Edunts5962/console-nes-esp32/hardware/kicad/manette_nes/documents/manette_nes_schema.pdf

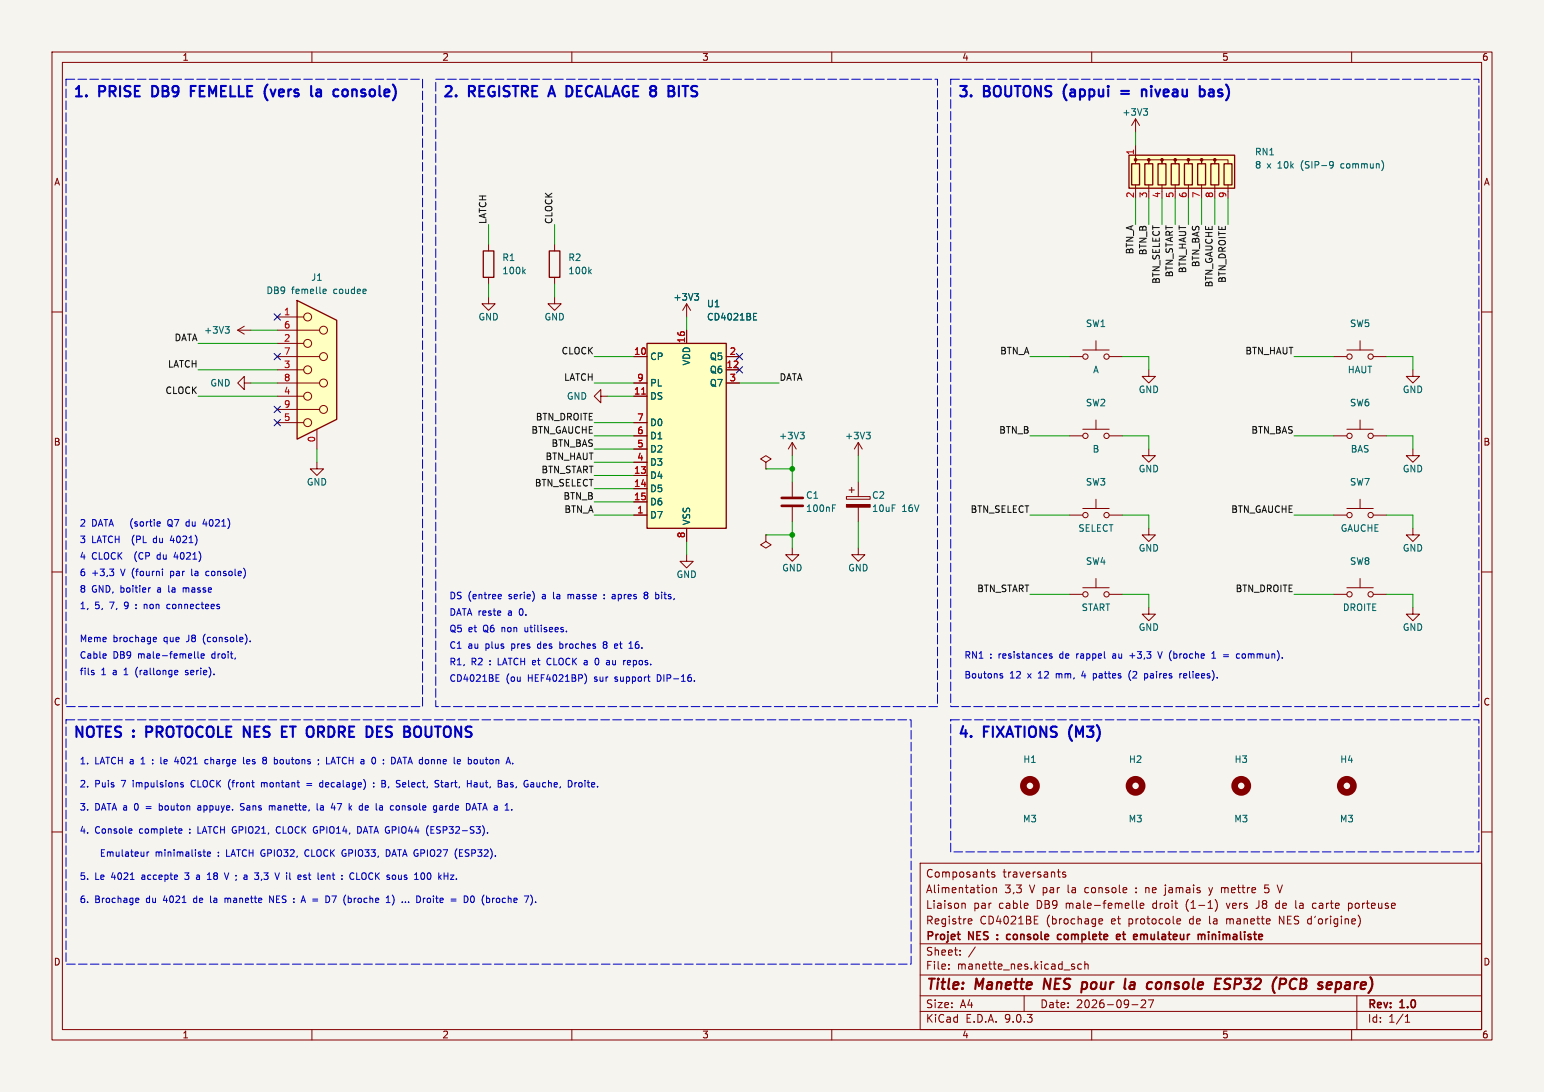
[picture p7: page 1]

Boutons 12 x 12 mm, 4 pattes (2 paires reliees).
