Edunts5962/console-nes-esp32/hardware/kicad/console_nes/documents/console_nes_placement.pdf

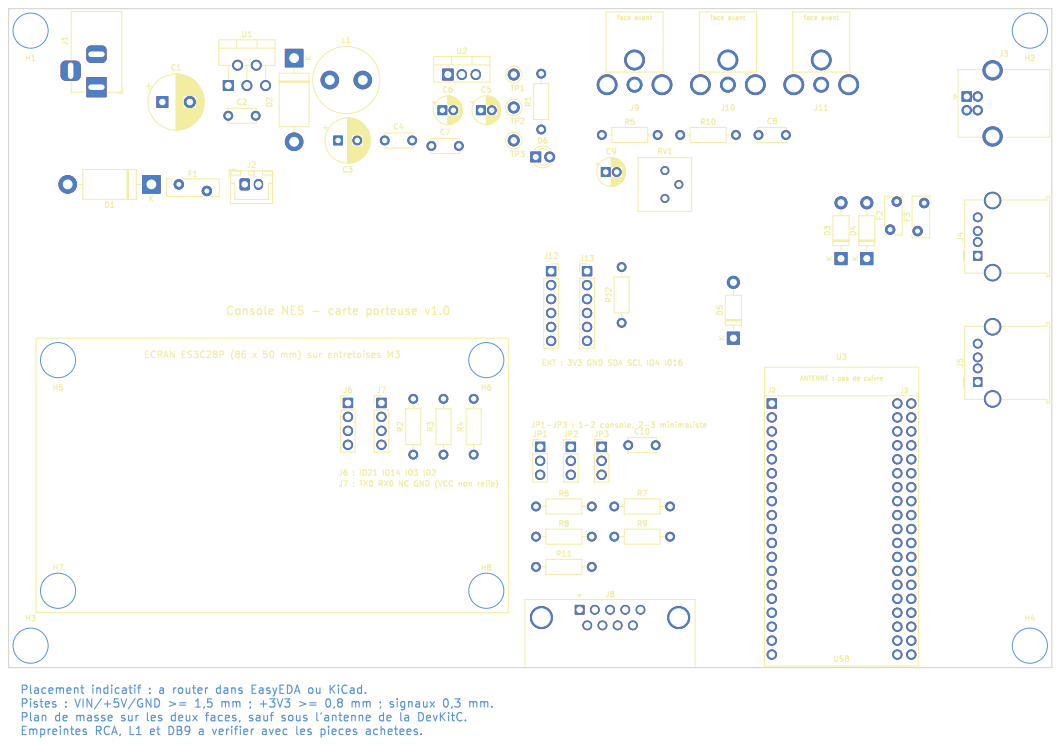
[picture p8: page 1]

ANTENNE : pas de cuivre USB
