Edunts5962/console-nes-esp32/hardware/kicad/console_nes/documents/console_nes_schema.pdf

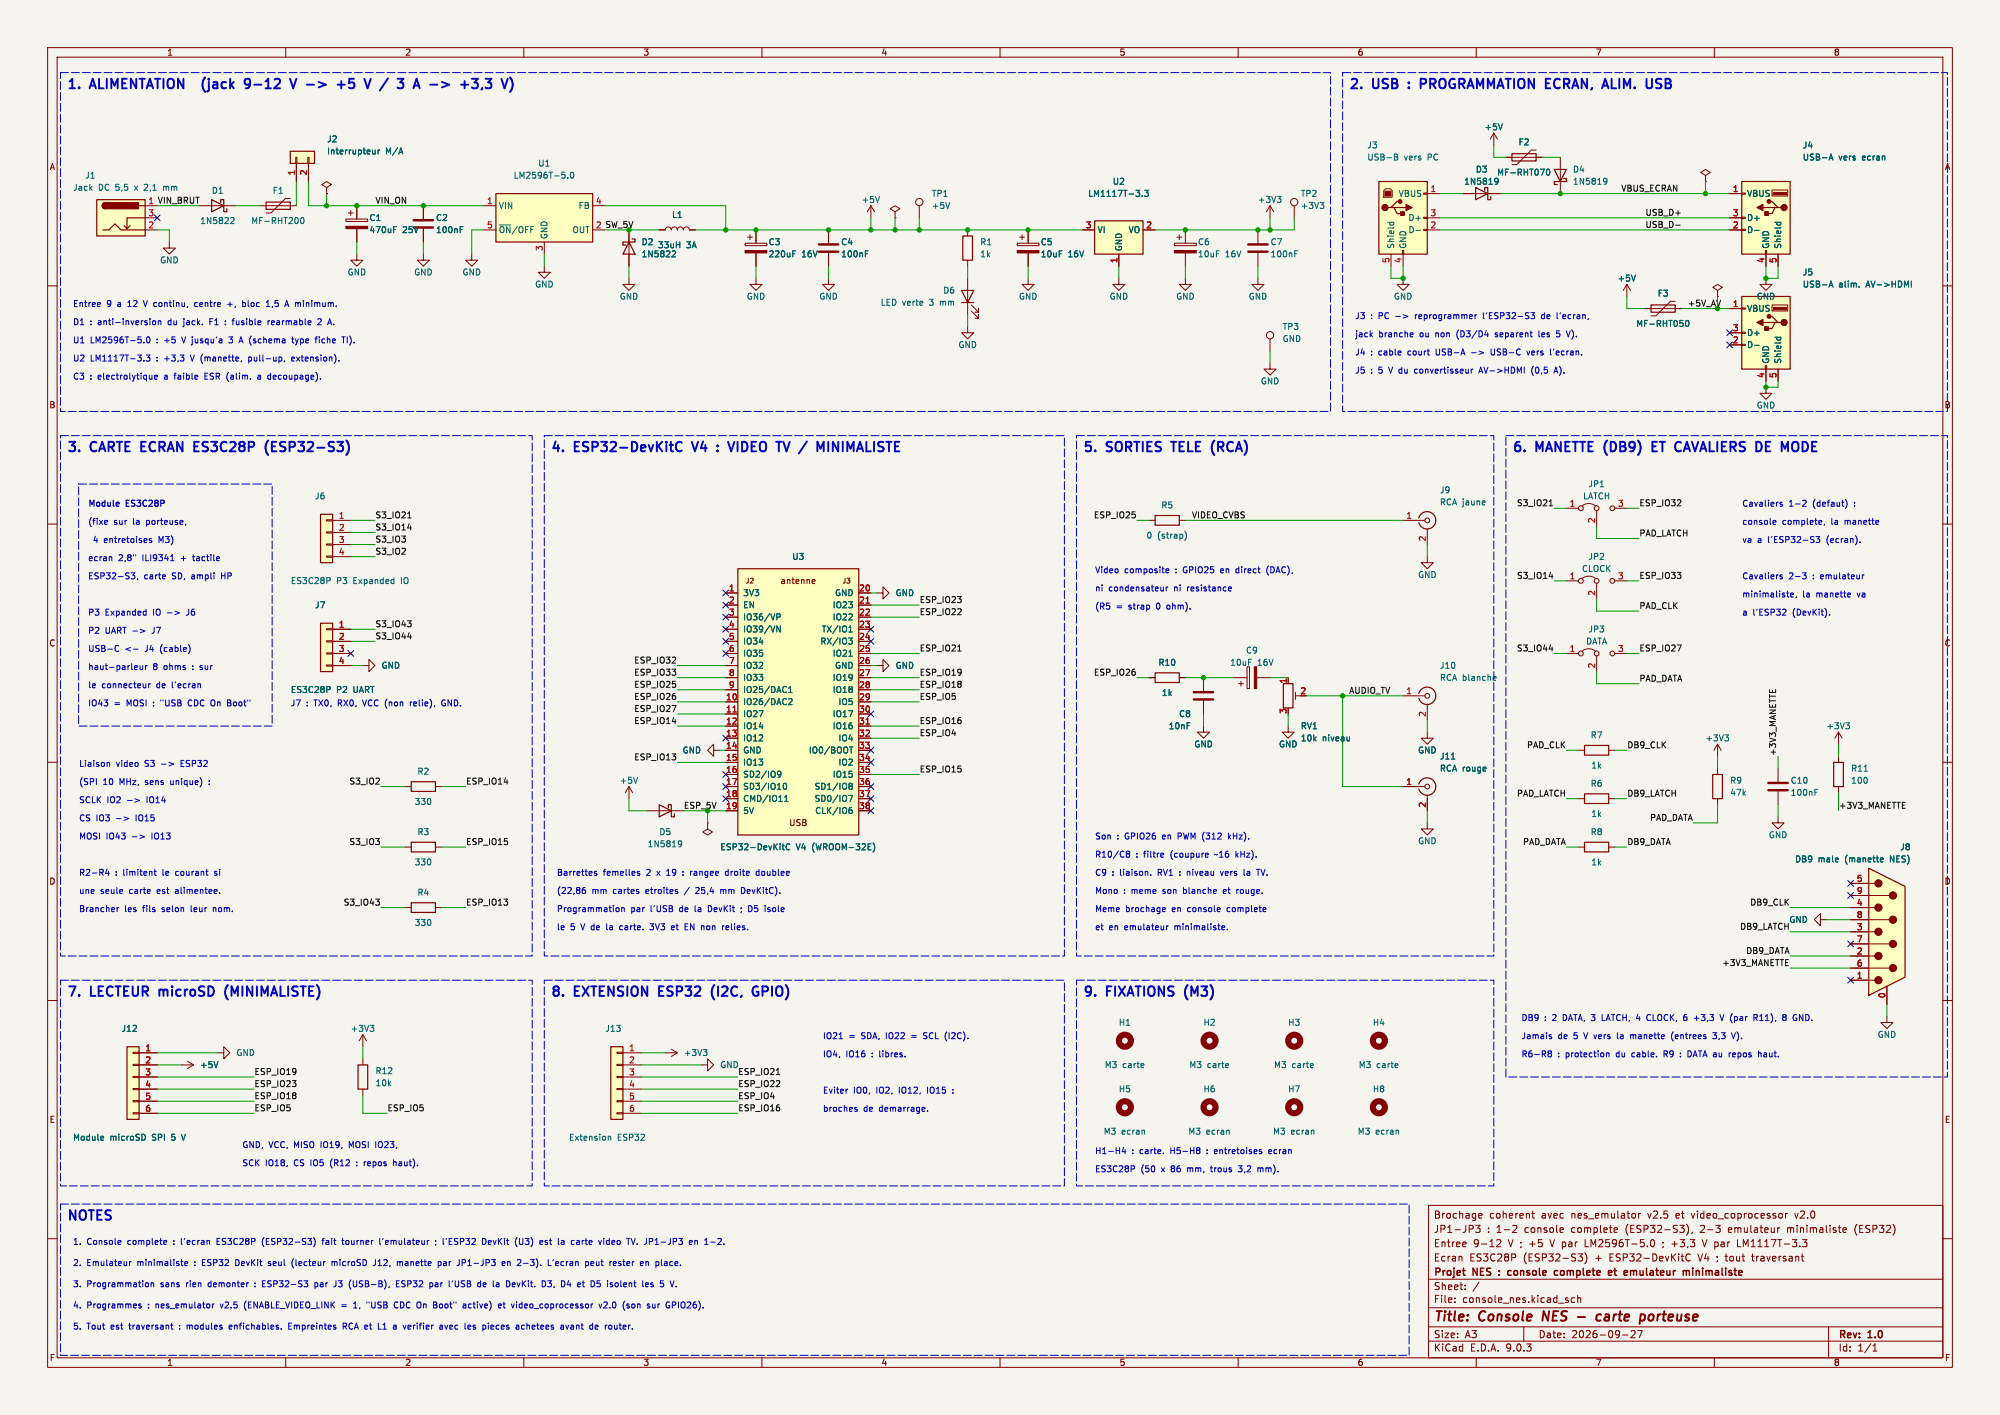
[picture p9: page 1]

J5USB-A alim. AV->HDMI Shield

6. MANETTE (DB9) ET CAVALIERS DE MODE
S3_IO21 PAD_CLK

IO43 = MOSI : "USB CDC On Boot"

Id: 1/1 Title: Console NES - carte porteuse
