Edunts5962/console-nes-esp32/hardware/kicad/manette_nes/documents/manette_nes_placement.pdf

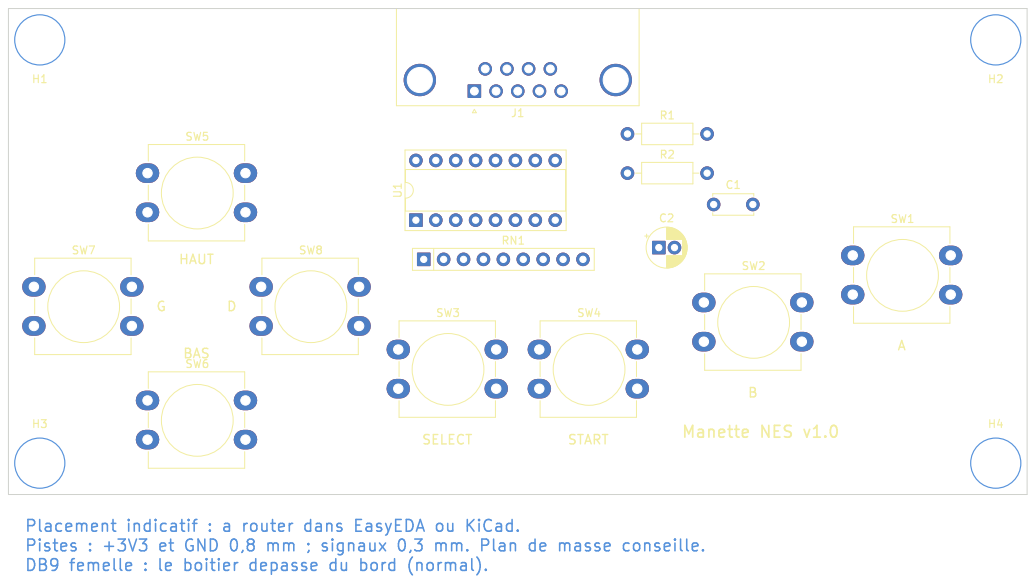
[picture p10: page 1]
