Edunts5962/console-nes-esp32/hardware/kicad/console_nes/console_nes.kicad_pcb

## KiCad design hardware/kicad/console_nes/console_nes.kicad_pcb (2026-10-17)

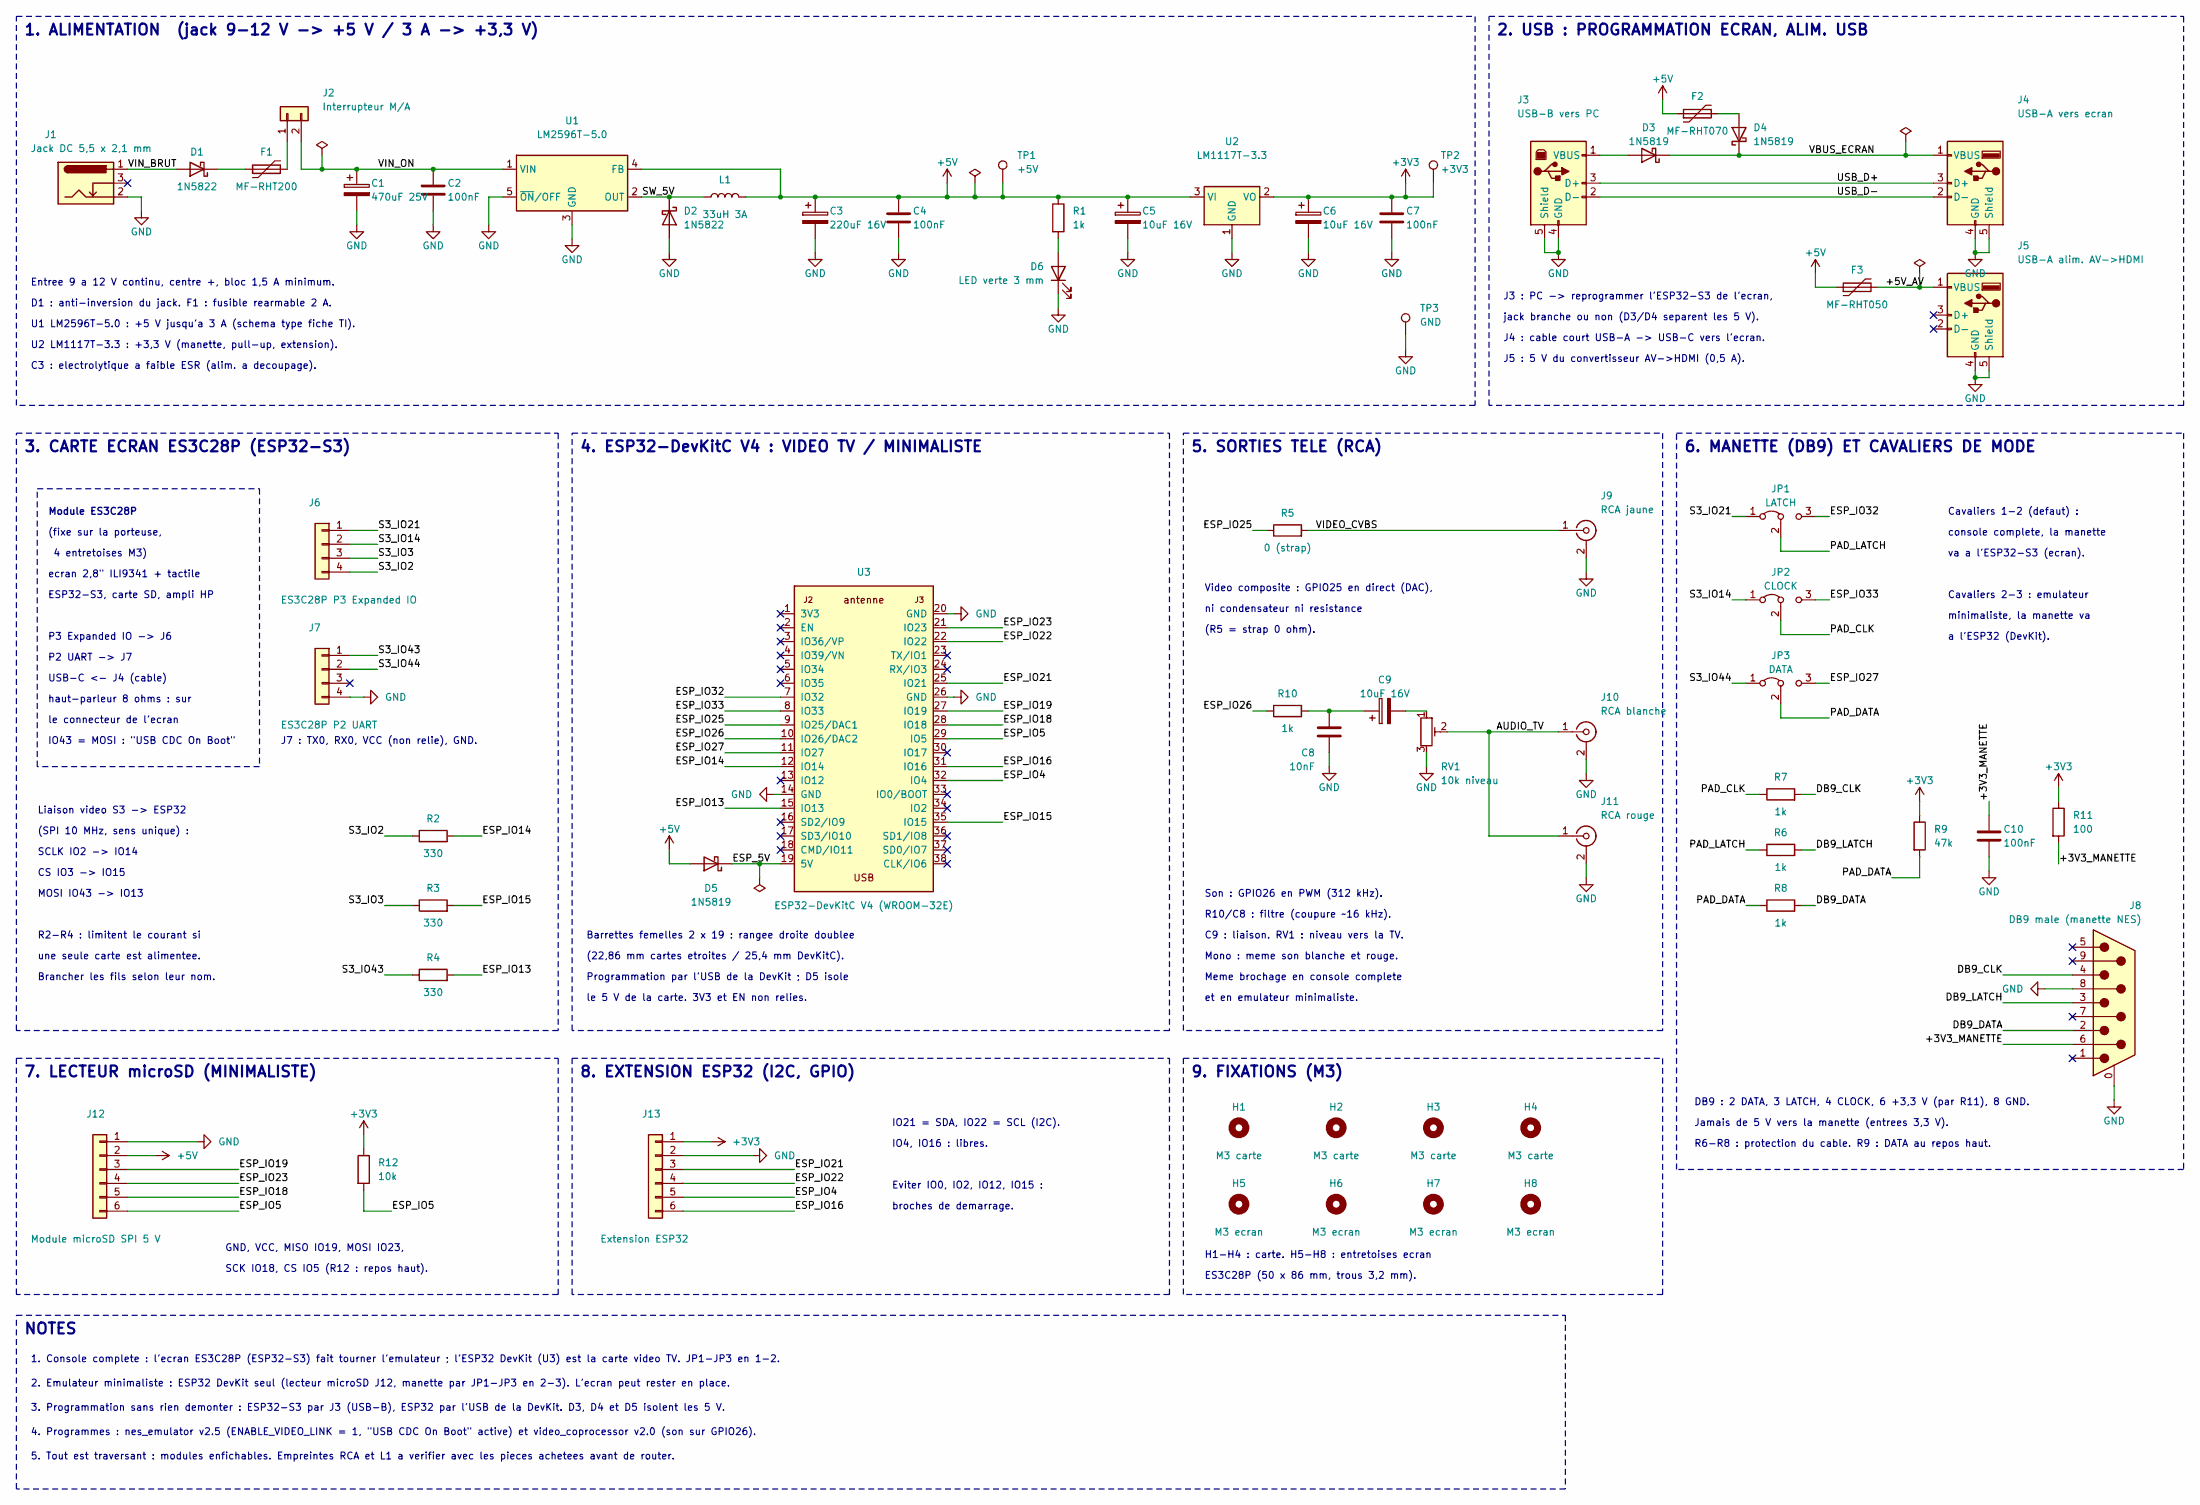
[picture p11: schematic console_nes.kicad_sch, Console NES - carte porteuse]

Parts:
C1: 470uF 25V; CP_Radial_D10.0mm_P5.00mm
C2, C4, C7, C10: 100nF; C_Disc_D5.0mm_W2.5mm_P5.00mm
C3: 220uF 16V; CP_Radial_D8.0mm_P3.50mm
C5, C6, C9: 10uF 16V; CP_Radial_D5.0mm_P2.00mm
C8: 10nF; C_Disc_D5.0mm_W2.5mm_P5.00mm
D1, D2: 1N5822; D_DO-201AD_P15.24mm_Horizontal
D3, D4, D5: 1N5819; D_DO-41_SOD81_P10.16mm_Horizontal
D6: LED verte 3 mm; LED_D3.0mm
F1: MF-RHT200; Fuse_Bourns_MF-RHT200
F2: MF-RHT070; Fuse_Bourns_MF-RHT070
F3: MF-RHT050; Fuse_Bourns_MF-RHT050
H1, H2, H3, H4: M3 carte; MountingHole_3.2mm_M3
H5, H6, H7, H8: M3 ecran; MountingHole_3.2mm_M3
J1: Jack DC 5,5 x 2,1 mm; BarrelJack_Horizontal
J2: Interrupteur M/A; JST_XH_B2B-XH-A_1x02_P2.50mm_Vertical
J3: USB-B vers PC; USB_B_OST_USB-B1HSxx_Horizontal
J4: USB-A vers ecran; USB_A_Molex_67643_Horizontal
J5: USB-A alim. AV->HDMI; USB_A_Molex_67643_Horizontal
J6: ES3C28P P3 Expanded IO; PinHeader_1x04_P2.54mm_Vertical
J7: ES3C28P P2 UART; PinHeader_1x04_P2.54mm_Vertical
J8: DB9 male (manette NES); DSUB-9_Male_Horizontal_P2.77x2.84mm_EdgePinOffset7.70mm_Hou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
J9: RCA jaune; RCA_Jack_CUI_RCJ-01x_Horizontal
J10: RCA blanche; RCA_Jack_CUI_RCJ-01x_Horizontal
J11: RCA rouge; RCA_Jack_CUI_RCJ-01x_Horizontal
J12: Module microSD SPI 5 V; PinSocket_1x06_P2.54mm_Vertical
J13: Extension ESP32; PinHeader_1x06_P2.54mm_Vertical
JP1: LATCH; PinHeader_1x03_P2.54mm_Vertical
JP2: CLOCK; PinHeader_1x03_P2.54mm_Vertical
JP3: DATA; PinHeader_1x03_P2.54mm_Vertical
L1: 33uH 3A; L_Radial_D12.0mm_P6.00mm_Murata_1900R
R1, R6, R7, R8, R10: 1k; R_Axial_DIN0207_L6.3mm_D2.5mm_P10.16mm_Horizontal
R2, R3, R4: 330; R_Axial_DIN0207_L6.3mm_D2.5mm_P10.16mm_Horizontal
R5: 0 (strap); R_Axial_DIN0207_L6.3mm_D2.5mm_P10.16mm_Horizontal
R9: 47k; R_Axial_DIN0207_L6.3mm_D2.5mm_P10.16mm_Horizontal
R11: 100; R_Axial_DIN0207_L6.3mm_D2.5mm_P10.16mm_Horizontal
R12: 10k; R_Axial_DIN0207_L6.3mm_D2.5mm_P10.16mm_Horizontal
RV1: 10k niveau; Potentiometer_Bourns_3386P_Vertical
TP1: +5V; TestPoint_Loop_D2.50mm_Drill1.0mm
TP2: +3V3; TestPoint_Loop_D2.50mm_Drill1.0mm
TP3: GND; TestPoint_Loop_D2.50mm_Drill1.0mm
U1: LM2596T-5.0; TO-220-5_P3.4x3.7mm_StaggerOdd_Lead3.8mm_Vertical
U2: LM1117T-3.3; TO-220-3_Vertical
U3: ESP32-DevKitC V4 (WROOM-32E); ESP32_DevKitC_V4_Socket_3rows

Connections:
+3V3: C6.1, C7.1, J13.1, R9.1, R11.1, R12.1, TP2.1, U2.2 (VO)
+5V: C3.1, C4.1, C5.1, D5.2 (A), F2.1, F3.1, J12.2, L1.2, R1.1, TP1.1, U1.4 (FB), U2.3 (VI)
/+3V3_MANETTE: C10.1, J8.6, R11.2
/+5V_AV: F3.2, J5.1 (VBUS)
/AUDIO_TV: J10.1 (In), J11.1 (In), RV1.2
/DB9_CLK: J8.4, R7.2
/DB9_DATA: J8.2, R8.2
/DB9_LATCH: J8.3, R6.2
/ESP_5V: D5.1 (K), U3.19 (5V)
/ESP_IO4: J13.5, U3.32 (IO4)
/ESP_IO5: J12.6, R12.2, U3.29 (IO5)
/ESP_IO13: R4.2, U3.15 (IO13)
/ESP_IO14: R2.2, U3.12 (IO14)
/ESP_IO15: R3.2, U3.35 (IO15)
/ESP_IO16: J13.6, U3.31 (IO16)
/ESP_IO18: J12.5, U3.28 (IO18)
/ESP_IO19: J12.3, U3.27 (IO19)
/ESP_IO21: J13.3, U3.25 (IO21)
/ESP_IO22: J13.4, U3.22 (IO22)
/ESP_IO23: J12.4, U3.21 (IO23)
/ESP_IO25: R5.1, U3.9 (IO25/DAC1)
/ESP_IO26: R10.1, U3.10 (IO26/DAC2)
/ESP_IO27: JP3.3 (B), U3.11 (IO27)
/ESP_IO32: JP1.3 (B), U3.7 (IO32)
/ESP_IO33: JP2.3 (B), U3.8 (IO33)
/PAD_CLK: JP2.2 (C), R7.1
/PAD_DATA: JP3.2 (C), R8.1, R9.2
/PAD_LATCH: JP1.2 (C), R6.1
/S3_IO2: J6.4, R2.1
/S3_IO3: J6.3, R3.1
/S3_IO14: J6.2, JP2.1 (A)
/S3_IO21: J6.1, JP1.1 (A)
/S3_IO43: J7.1, R4.1
/S3_IO44: J7.2, JP3.1 (A)
/SW_5V: D2.1 (K), L1.1, U1.2 (OUT)
/USB_D+: J3.3 (D+), J4.3 (D+)
/USB_D-: J3.2 (D-), J4.2 (D-)
/VBUS_ECRAN: D3.1 (K), D4.1 (K), J4.1 (VBUS)
/VIDEO_CVBS: J9.1 (In), R5.2
/VIN_BRUT: D1.2 (A), J1.1
/VIN_ON: C1.1, C2.1, J2.2, U1.1 (VIN)
GND: C1.2, C2.2, C3.2, C4.2, C5.2, C6.2, C7.2, C8.2, C10.2, D2.2 (A), D6.1 (K), J1.2, J3.4 (GND), J3.5 (Shield), J4.4 (GND), J4.5 (Shield), J5.4 (GND), J5.5 (Shield), J7.4, J8.0 (PAD), J8.8, J9.2 (Ext), J10.2 (Ext), J11.2 (Ext), J12.1, J13.2, RV1.3, TP3.1, U1.3 (GND), U1.5 (~ON/OFF), U2.1 (GND), U3.14 (GND), U3.20 (GND), U3.26 (GND)
unnamed: C8.1, C9.1, R10.2
unnamed: C9.2, RV1.1
unnamed: D1.1 (K), F1.1
unnamed: D3.2 (A), J3.1 (VBUS)
unnamed: D4.2 (A), F2.2
unnamed: D6.2 (A), R1.2
unnamed: F1.2, J2.1

Notes on the sheet:
1. ALIMENTATION (jack 9-12 V -> +5 V / 3 A -> +3,3 V)
Entree 9 a 12 V continu, centre +, bloc 1,5 A minimum.
D1 : anti-inversion du jack. F1 : fusible rearmable 2 A.
U1 LM2596T-5.0 : +5 V jusqu'a 3 A (schema type fiche TI).
U2 LM1117T-3.3 : +3,3 V (manette, pull-up, extension).
C3 : electrolytique a faible ESR (alim. a decoupage).
2. USB : PROGRAMMATION ECRAN, ALIM. USB
J3 : PC -> reprogrammer l'ESP32-S3 de l'ecran,
jack branche ou non (D3/D4 separent les 5 V).
J4 : cable court USB-A -> USB-C vers l'ecran.
J5 : 5 V du convertisseur AV->HDMI (0,5 A).
3. CARTE ECRAN ES3C28P (ESP32-S3)
Module ES3C28P
(fixe sur la porteuse,
4 entretoises M3)
ecran 2,8" ILI9341 + tactile
ESP32-S3, carte SD, ampli HP
P3 Expanded IO -> J6
P2 UART -> J7
USB-C <- J4 (cable)
haut-parleur 8 ohms : sur
le connecteur de l'ecran
IO43 = MOSI : "USB CDC On Boot"
J7 : TX0, RX0, VCC (non relie), GND.
Liaison video S3 -> ESP32
(SPI 10 MHz, sens unique) :
SCLK IO2 -> IO14
CS IO3 -> IO15
MOSI IO43 -> IO13
R2-R4 : limitent le courant si
une seule carte est alimentee.
Brancher les fils selon leur nom.
4. ESP32-DevKitC V4 : VIDEO TV / MINIMALISTE
Barrettes femelles 2 x 19 : rangee droite doublee
(22,86 mm cartes etroites / 25,4 mm DevKitC).
Programmation par l'USB de la DevKit ; D5 isole
le 5 V de la carte. 3V3 et EN non relies.
5. SORTIES TELE (RCA)
Video composite : GPIO25 en direct (DAC),
ni condensateur ni resistance
(R5 = strap 0 ohm).
Son : GPIO26 en PWM (312 kHz).
R10/C8 : filtre (coupure ~16 kHz).
C9 : liaison. RV1 : niveau vers la TV.
Mono : meme son blanche et rouge.
Meme brochage en console complete
et en emulateur minimaliste.
6. MANETTE (DB9) ET CAVALIERS DE MODE
Cavaliers 1-2 (defaut) :
console complete, la manette
va a l'ESP32-S3 (ecran).
Cavaliers 2-3 : emulateur
minimaliste, la manette va
a l'ESP32 (DevKit).
DB9 : 2 DATA, 3 LATCH, 4 CLOCK, 6 +3,3 V (par R11), 8 GND.
Jamais de 5 V vers la manette (entrees 3,3 V).
R6-R8 : protection du cable. R9 : DATA au repos haut.
7. LECTEUR microSD (MINIMALISTE)
GND, VCC, MISO IO19, MOSI IO23,
SCK IO18, CS IO5 (R12 : repos haut).
8. EXTENSION ESP32 (I2C, GPIO)
IO21 = SDA, IO22 = SCL (I2C).
IO4, IO16 : libres.
Eviter IO0, IO2, IO12, IO15 :
broches de demarrage.
9. FIXATIONS (M3)
H1-H4 : carte. H5-H8 : entretoises ecran
ES3C28P (50 x 86 mm, trous 3,2 mm).
NOTES
1. Console complete : l'ecran ES3C28P (ESP32-S3) fait tourner l'emulateur ; l'ESP32 DevKit (U3) est la carte video TV. JP1-JP3 en 1-2.
2. Emulateur minimaliste : ESP32 DevKit seul (lecteur microSD J12, manette par JP1-JP3 en 2-3). L'ecran peut rester en place.
3. Programmation sans rien demonter : ESP32-S3 par J3 (USB-B), ESP32 par l'USB de la DevKit. D3, D4 et D5 isolent les 5 V.
4. Programmes : nes_emulator v2.5 (ENABLE_VIDEO_LINK = 1, "USB CDC On Boot" active) et video_coprocessor v2.0 (son sur GPIO26).
5. Tout est traversant : modules enfichables. Empreintes RCA et L1 a verifier avec les pieces achetees avant de router.

Board: 2 copper layers, 63 parts (0 on the bottom side), 49 nets, no tracks yet.
