Edunts5962/console-nes-esp32/hardware/kicad/manette_nes/manette_nes.kicad_pcb

## KiCad design hardware/kicad/manette_nes/manette_nes.kicad_pcb (2026-10-17)

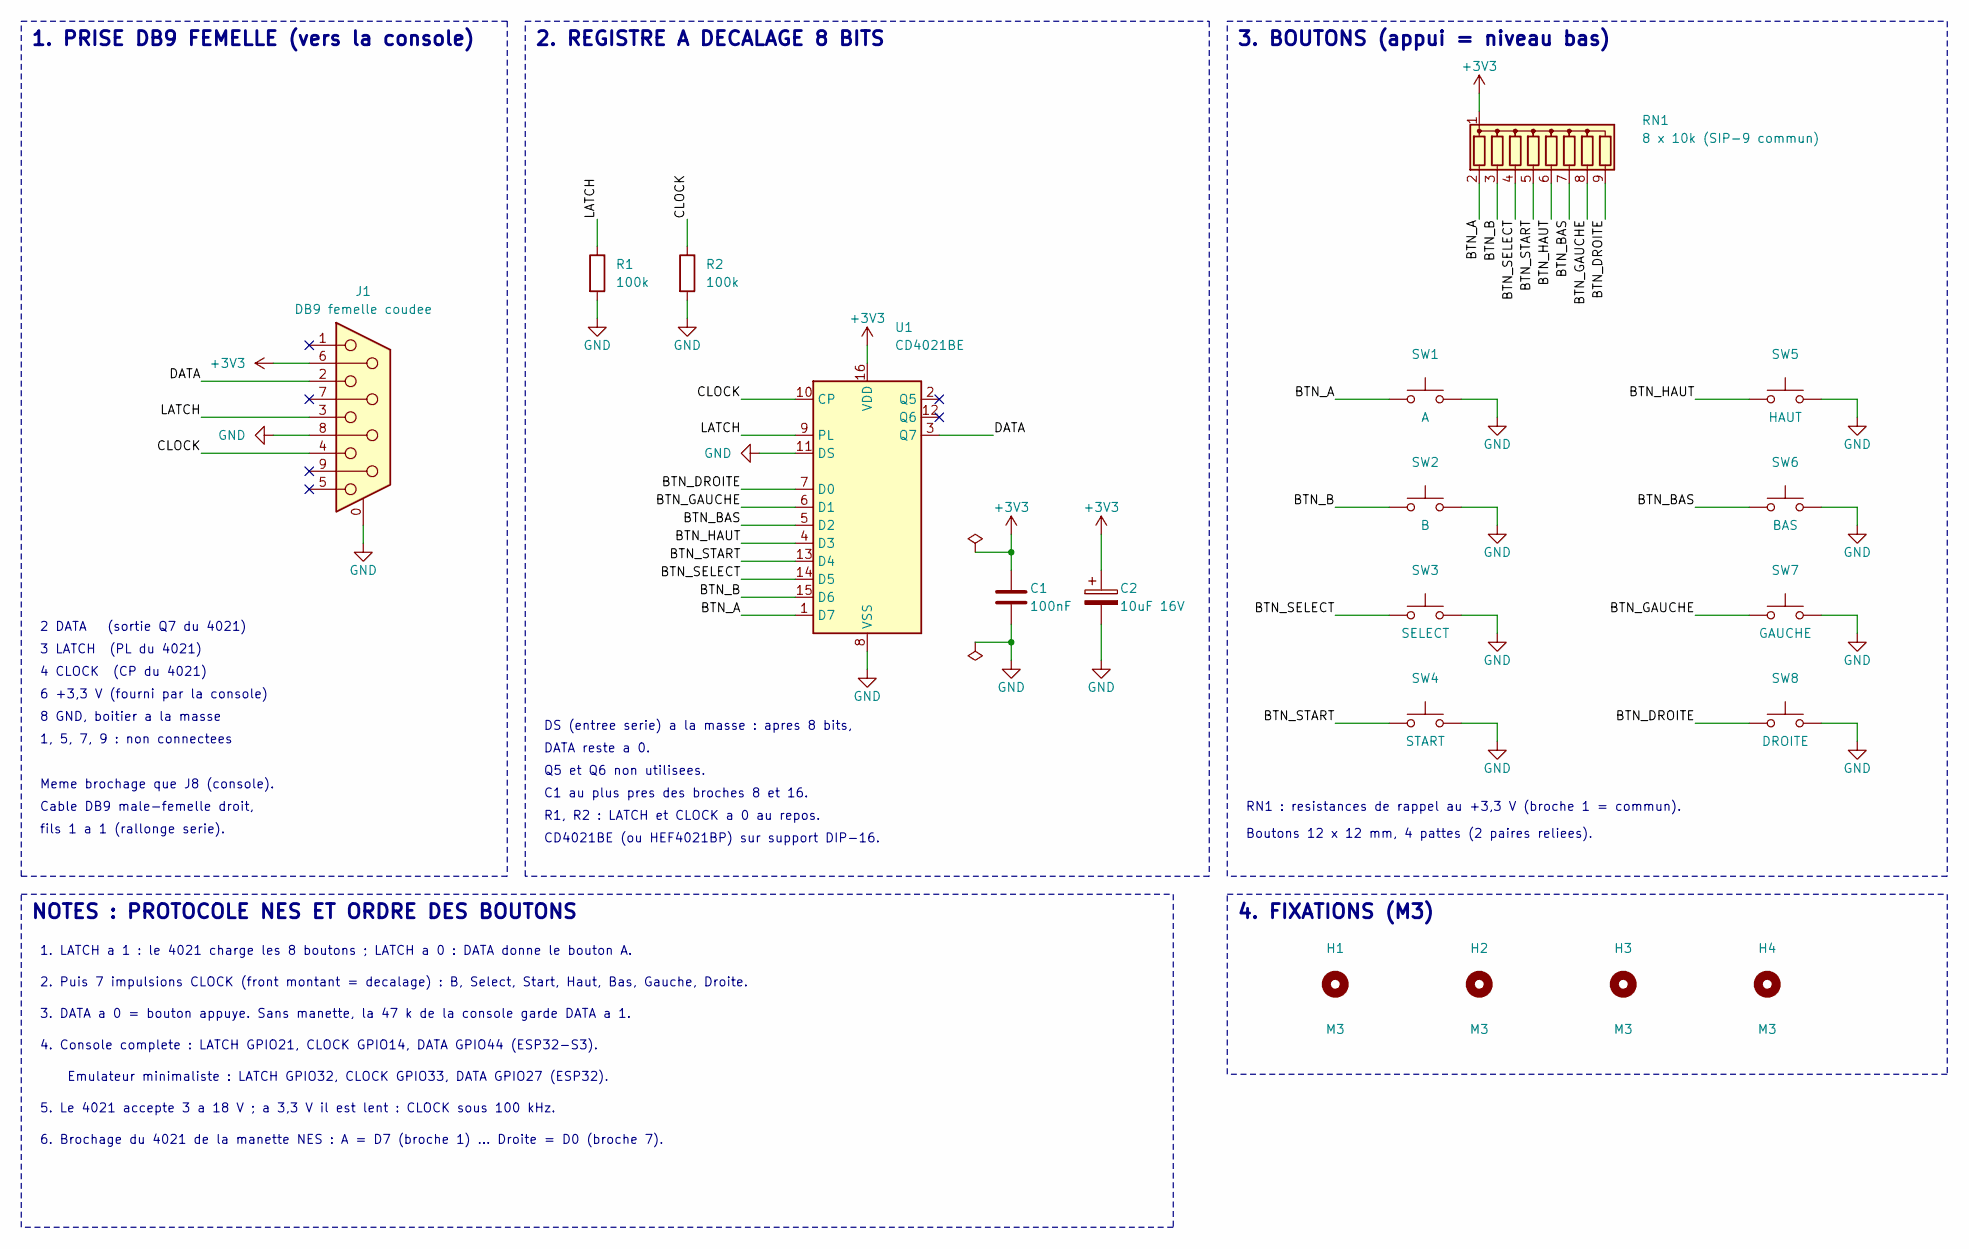
[picture p12: schematic manette_nes.kicad_sch, Manette NES pour la console ESP32 (PCB separe)]

Parts:
C1: 100nF; C_Disc_D5.0mm_W2.5mm_P5.00mm
C2: 10uF 16V; CP_Radial_D5.0mm_P2.00mm
H1, H2, H3, H4: M3; MountingHole_3.2mm_M3
J1: DB9 femelle coudee; DSUB-9_Female_Horizontal_P2.77x2.84mm_EdgePinOffset7.70mm_H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
R1, R2: 100k; R_Axial_DIN0207_L6.3mm_D2.5mm_P10.16mm_Horizontal
RN1: 8 x 10k (SIP-9 commun); R_Array_SIP9
SW1: A; SW_PUSH-12mm_Wuerth-430476085716
SW2: B; SW_PUSH-12mm_Wuerth-430476085716
SW3: SELECT; SW_PUSH-12mm_Wuerth-430476085716
SW4: START; SW_PUSH-12mm_Wuerth-430476085716
SW5: HAUT; SW_PUSH-12mm_Wuerth-430476085716
SW6: BAS; SW_PUSH-12mm_Wuerth-430476085716
SW7: GAUCHE; SW_PUSH-12mm_Wuerth-430476085716
SW8: DROITE; SW_PUSH-12mm_Wuerth-430476085716
U1: CD4021BE; DIP-16_W7.62mm_Socket

Connections:
+3V3: C1.1, C2.1, J1.6, RN1.1 (common), U1.16 (VDD)
/BTN_A: RN1.2 (R1), SW1.1, U1.1 (D7)
/BTN_B: RN1.3 (R2), SW2.1, U1.15 (D6)
/BTN_BAS: RN1.7 (R6), SW6.1, U1.5 (D2)
/BTN_DROITE: RN1.9 (R8), SW8.1, U1.7 (D0)
/BTN_GAUCHE: RN1.8 (R7), SW7.1, U1.6 (D1)
/BTN_HAUT: RN1.6 (R5), SW5.1, U1.4 (D3)
/BTN_SELECT: RN1.4 (R3), SW3.1, U1.14 (D5)
/BTN_START: RN1.5 (R4), SW4.1, U1.13 (D4)
/CLOCK: J1.4, R2.1, U1.10 (CP)
/DATA: J1.2, U1.3 (Q7)
/LATCH: J1.3, R1.1, U1.9 (PL)
GND: C1.2, C2.2, J1.0 (PAD), J1.8, R1.2, R2.2, SW1.2, SW2.2, SW3.2, SW4.2, SW5.2, SW6.2, SW7.2, SW8.2, U1.8 (VSS), U1.11 (DS)

Notes on the sheet:
1. PRISE DB9 FEMELLE (vers la console)
2 DATA (sortie Q7 du 4021)
3 LATCH (PL du 4021)
4 CLOCK (CP du 4021)
6 +3,3 V (fourni par la console)
8 GND, boitier a la masse
1, 5, 7, 9 : non connectees
Meme brochage que J8 (console).
Cable DB9 male-femelle droit,
fils 1 a 1 (rallonge serie).
2. REGISTRE A DECALAGE 8 BITS
DS (entree serie) a la masse : apres 8 bits,
DATA reste a 0.
Q5 et Q6 non utilisees.
C1 au plus pres des broches 8 et 16.
R1, R2 : LATCH et CLOCK a 0 au repos.
CD4021BE (ou HEF4021BP) sur support DIP-16.
3. BOUTONS (appui = niveau bas)
RN1 : resistances de rappel au +3,3 V (broche 1 = commun).
Boutons 12 x 12 mm, 4 pattes (2 paires reliees).
NOTES : PROTOCOLE NES ET ORDRE DES BOUTONS
1. LATCH a 1 : le 4021 charge les 8 boutons ; LATCH a 0 : DATA donne le bouton A.
2. Puis 7 impulsions CLOCK (front montant = decalage) : B, Select, Start, Haut, Bas, Gauche, Droite.
3. DATA a 0 = bouton appuye. Sans manette, la 47 k de la console garde DATA a 1.
4. Console complete : LATCH GPIO21, CLOCK GPIO14, DATA GPIO44 (ESP32-S3).
Emulateur minimaliste : LATCH GPIO32, CLOCK GPIO33, DATA GPIO27 (ESP32).
5. Le 4021 accepte 3 a 18 V ; a 3,3 V il est lent : CLOCK sous 100 kHz.
6. Brochage du 4021 de la manette NES : A = D7 (broche 1) ... Droite = D0 (broche 7).
4. FIXATIONS (M3)

Board: 2 copper layers, 19 parts (0 on the bottom side), 13 nets, no tracks yet.
