Edunts5962/console-nes-esp32/firmware/nes_emulator/libsnss.c

/**************************************************************************/
/*
      libsnss.c

      (C) 2000 The SNSS Group
      See README.TXT file for license and terms of use.

      $Id: libsnss.c,v 1.2 2001/04/27 14:37:11 neil Exp $
*/
/**************************************************************************/
/*
** Modifie depuis la version d'origine de nofrendo : portages ESP32
** (esp32-nesemu d'Espressif, puis Esp32-S3-nes-emulator-by-DSN) et projet
** Console NES ESP32 (2026). Origines et licences : fichier NOTICE.
*/

#include <stdio.h>
#include <stdlib.h>
#include <string.h>
#include "libsnss.h"
 
static unsigned int
swap32(unsigned int source)
{
#ifdef USE_LITTLE_ENDIAN
   char buffer[4];

   buffer[0] = ((char *)&source)[3];
   buffer[1] = ((char *)&source)[2];
   buffer[2] = ((char *)&source)[1];
   buffer[3] = ((char *)&source)[0];

   return *((unsigned int *)buffer);
#else   
   return source;
#endif  
}

static unsigned short
swap16(unsigned short source)
{
#ifdef USE_LITTLE_ENDIAN
   char buffer[2];

   buffer[0] = ((char *)&source)[1];
   buffer[1] = ((char *)&source)[0];

   return *((unsigned short *)buffer);
#else  
   return source;
#endif  
}
 
#define MIN(a, b) (((a) < (b)) ? (a) : (b))
 
static SNSS_RETURN_CODE
SNSS_ReadBlockHeader(SnssBlockHeader *header, SNSS_FILE *snssFile)
{
   char headerBytes[12];

   if (fread(headerBytes, 12, 1, snssFile->fp) != 1)
   {
      return SNSS_READ_FAILED;
   }

   strncpy(header->tag, &headerBytes[0], TAG_LENGTH);
   header->tag[4] = '\0';
   header->blockVersion = *((unsigned int *)&headerBytes[4]);
   header->blockVersion = swap32(header->blockVersion);
   header->blockLength = *((unsigned int *)&headerBytes[8]);
   header->blockLength = swap32(header->blockLength);

   return SNSS_OK;
}
 
static SNSS_RETURN_CODE
SNSS_WriteBlockHeader(SnssBlockHeader *header, SNSS_FILE *snssFile)
{
   char headerBytes[12];
   unsigned int tempInt;

   strncpy(&headerBytes[0], header->tag, TAG_LENGTH);

   tempInt = swap32(header->blockVersion);
   headerBytes[4] = ((char *)&tempInt)[0];
   headerBytes[5] = ((char *)&tempInt)[1];
   headerBytes[6] = ((char *)&tempInt)[2];
   headerBytes[7] = ((char *)&tempInt)[3];

   tempInt = swap32(header->blockLength);
   headerBytes[8] = ((char *)&tempInt)[0];
   headerBytes[9] = ((char *)&tempInt)[1];
   headerBytes[10] = ((char *)&tempInt)[2];
   headerBytes[11] = ((char *)&tempInt)[3];

   if (fwrite(headerBytes, 12, 1, snssFile->fp) != 1)
   {
      return SNSS_WRITE_FAILED;
   }

   return SNSS_OK;
}

const char *
SNSS_GetErrorString(SNSS_RETURN_CODE code)
{
   switch (code)
   {
   case SNSS_OK:
      return "no error";

   case SNSS_BAD_FILE_TAG:
      return "not an SNSS file";

   case SNSS_OPEN_FAILED:
      return "could not open SNSS file";

   case SNSS_CLOSE_FAILED:
      return "could not close SNSS file";

   case SNSS_READ_FAILED:
      return "could not read from SNSS file";

   case SNSS_WRITE_FAILED:
      return "could not write to SNSS file";

   case SNSS_OUT_OF_MEMORY:
      return "out of memory";

   case SNSS_UNSUPPORTED_BLOCK:
      return "unsupported block type";

   default:
      return "unknown error";
   }
}
 
static SNSS_RETURN_CODE
SNSS_ReadFileHeader(SNSS_FILE *snssFile)
{
   if (fread(snssFile->headerBlock.tag, 4, 1, snssFile->fp) != 1)
   {
      return SNSS_READ_FAILED;
   }

   if (0 != strncmp(snssFile->headerBlock.tag, "SNSS", 5))
   {
      return SNSS_BAD_FILE_TAG;
   }

   snssFile->headerBlock.tag[4] = '\0';

   if (fread(&snssFile->headerBlock.numberOfBlocks, sizeof(unsigned int), 1, snssFile->fp) != 1)
   {
      return SNSS_READ_FAILED;
   }

   snssFile->headerBlock.numberOfBlocks = swap32(snssFile->headerBlock.numberOfBlocks);

   return SNSS_OK;
}

static SNSS_RETURN_CODE
SNSS_WriteFileHeader(SNSS_FILE *snssFile)
{
   unsigned int tempInt;
   char writeBuffer[8];
 
   strncpy(&writeBuffer[0], "SNSS", 5);
   tempInt = swap32(snssFile->headerBlock.numberOfBlocks);
   writeBuffer[4] = ((char *)&tempInt)[0];
   writeBuffer[5] = ((char *)&tempInt)[1];
   writeBuffer[6] = ((char *)&tempInt)[2];
   writeBuffer[7] = ((char *)&tempInt)[3];

   if (fwrite(writeBuffer, 8, 1, snssFile->fp) != 1)
   {
      return SNSS_WRITE_FAILED;
   }

   return SNSS_OK;
}
 
SNSS_RETURN_CODE
SNSS_OpenFile(SNSS_FILE **snssFile, const char *filename, SNSS_OPEN_MODE mode)
{
   if (!snssFileBlock)
   {
      snssFileBlock = NOFRENDO_MALLOC(sizeof(SNSS_FILE));
   }
   *snssFile = snssFileBlock;
   if (NULL == *snssFile)
   {
      return SNSS_OUT_OF_MEMORY;
   }
 
   memset(*snssFile, 0, sizeof(SNSS_FILE));

   (*snssFile)->mode = mode;

   if (SNSS_OPEN_READ == mode)
   {
      (*snssFile)->fp = fopen(filename, "rb");
   }
   else
   {
      (*snssFile)->fp = fopen(filename, "wb");
      (*snssFile)->headerBlock.numberOfBlocks = 0;
   }

   if (NULL == (*snssFile)->fp)
   {
      return SNSS_OPEN_FAILED;
   }

   if (SNSS_OPEN_READ == mode)
   {
      return SNSS_ReadFileHeader(*snssFile);
   }
   else
   {
      return SNSS_WriteFileHeader(*snssFile);
   }
}

SNSS_RETURN_CODE
SNSS_CloseFile(SNSS_FILE **snssFile)
{
   int prevLoc;
   SNSS_RETURN_CODE code;
 
   if (NULL == *snssFile)
   {
      return SNSS_OK;
   }

   if (SNSS_OPEN_WRITE == (*snssFile)->mode)
   {
      prevLoc = ftell((*snssFile)->fp);
      fseek((*snssFile)->fp, 0, SEEK_SET);
 
      if (SNSS_OK != (code = SNSS_WriteFileHeader(*snssFile)))
      {
         return SNSS_CLOSE_FAILED;
      }

      fseek((*snssFile)->fp, prevLoc, SEEK_SET);
   }

   if (fclose((*snssFile)->fp) != 0)
   {
      return SNSS_CLOSE_FAILED;
   }

   return SNSS_OK;
}
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
